Tobias66662/SPRO3---PCB-Design-/Main PCB/Step (Main PCB).step

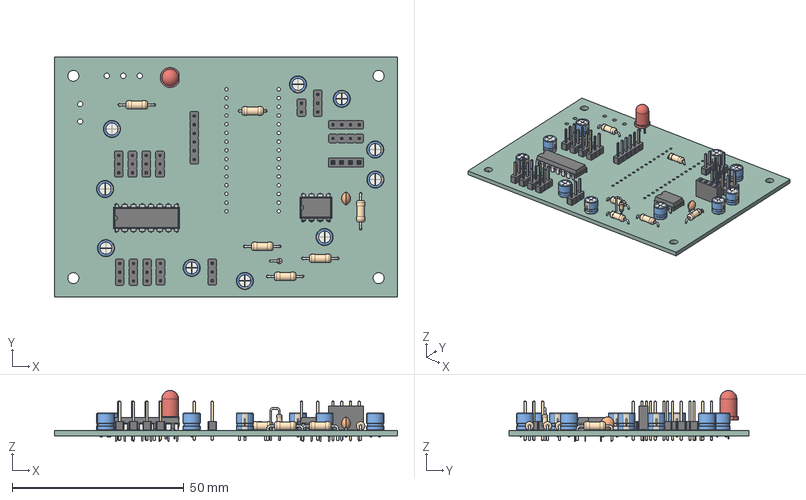
[picture p1: CAD file, 2024-12-10]
Main PCB/Step (Main PCB).step
100.0 x 70.0 x 14.9 mm
CP_Radial_D50mm_P250mm x 10
C_Disc_D38mm_W26mm_P250mm
R_Axial_DIN0207_L63mm_D25mm_P1016mm_Horizontal x 5
PinHeader_1x03_P254mm_Vertical x 10
DIP-8_W7.62mm
PinSocket_1x04_P254mm_Vertical
R_Axial_DIN0207_L63mm_D25mm_P762mm_Horizontal
PinHeader_1x06_P254mm_Vertical
PinHeader_1x04_P254mm_Vertical x 2
LED_D5.0mm
R_Axial_DIN0204_L36mm_D16mm_P254mm_Vertical
PinHeader_1x02_P254mm_Vertical
DIP-16_W7.62mm
Main PCB_PCB
