Tobias66662/SPRO3---PCB-Design-/2nd PCB/STEP (2nd PCB).step

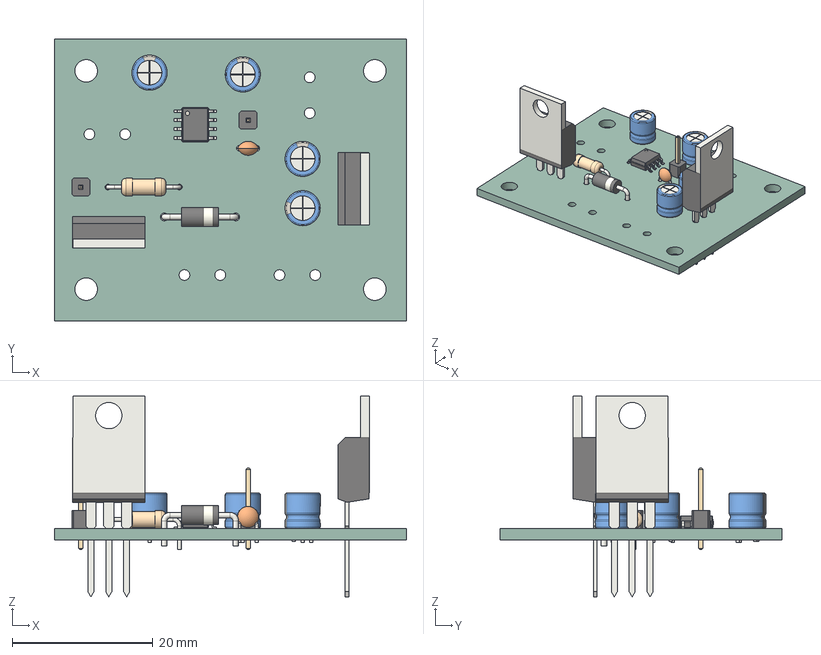
[picture p2: CAD file, 2024-12-10]
2nd PCB/STEP (2nd PCB).step
50.0 x 40.0 x 28.5 mm
CP_Radial_D50mm_P250mm x 4
D_DO-41_SOD81_P10.16mm_Horizontal
PinHeader_1x01_P254mm_Vertical x 2
C_Disc_D30mm_W20mm_P250mm
TO-220-3_Vertical x 2
R_Axial_DIN0207_L63mm_D25mm_P1016mm_Horizontal
SOIC_8_39x49mm_P127mm
2nd PCB_PCB
