Tobias66662/SPRO3---PCB-Design-/Main PCB/Main PCB.kicad_pcb

## KiCad design Main PCB/Main PCB.kicad_pcb (2024-12-17)

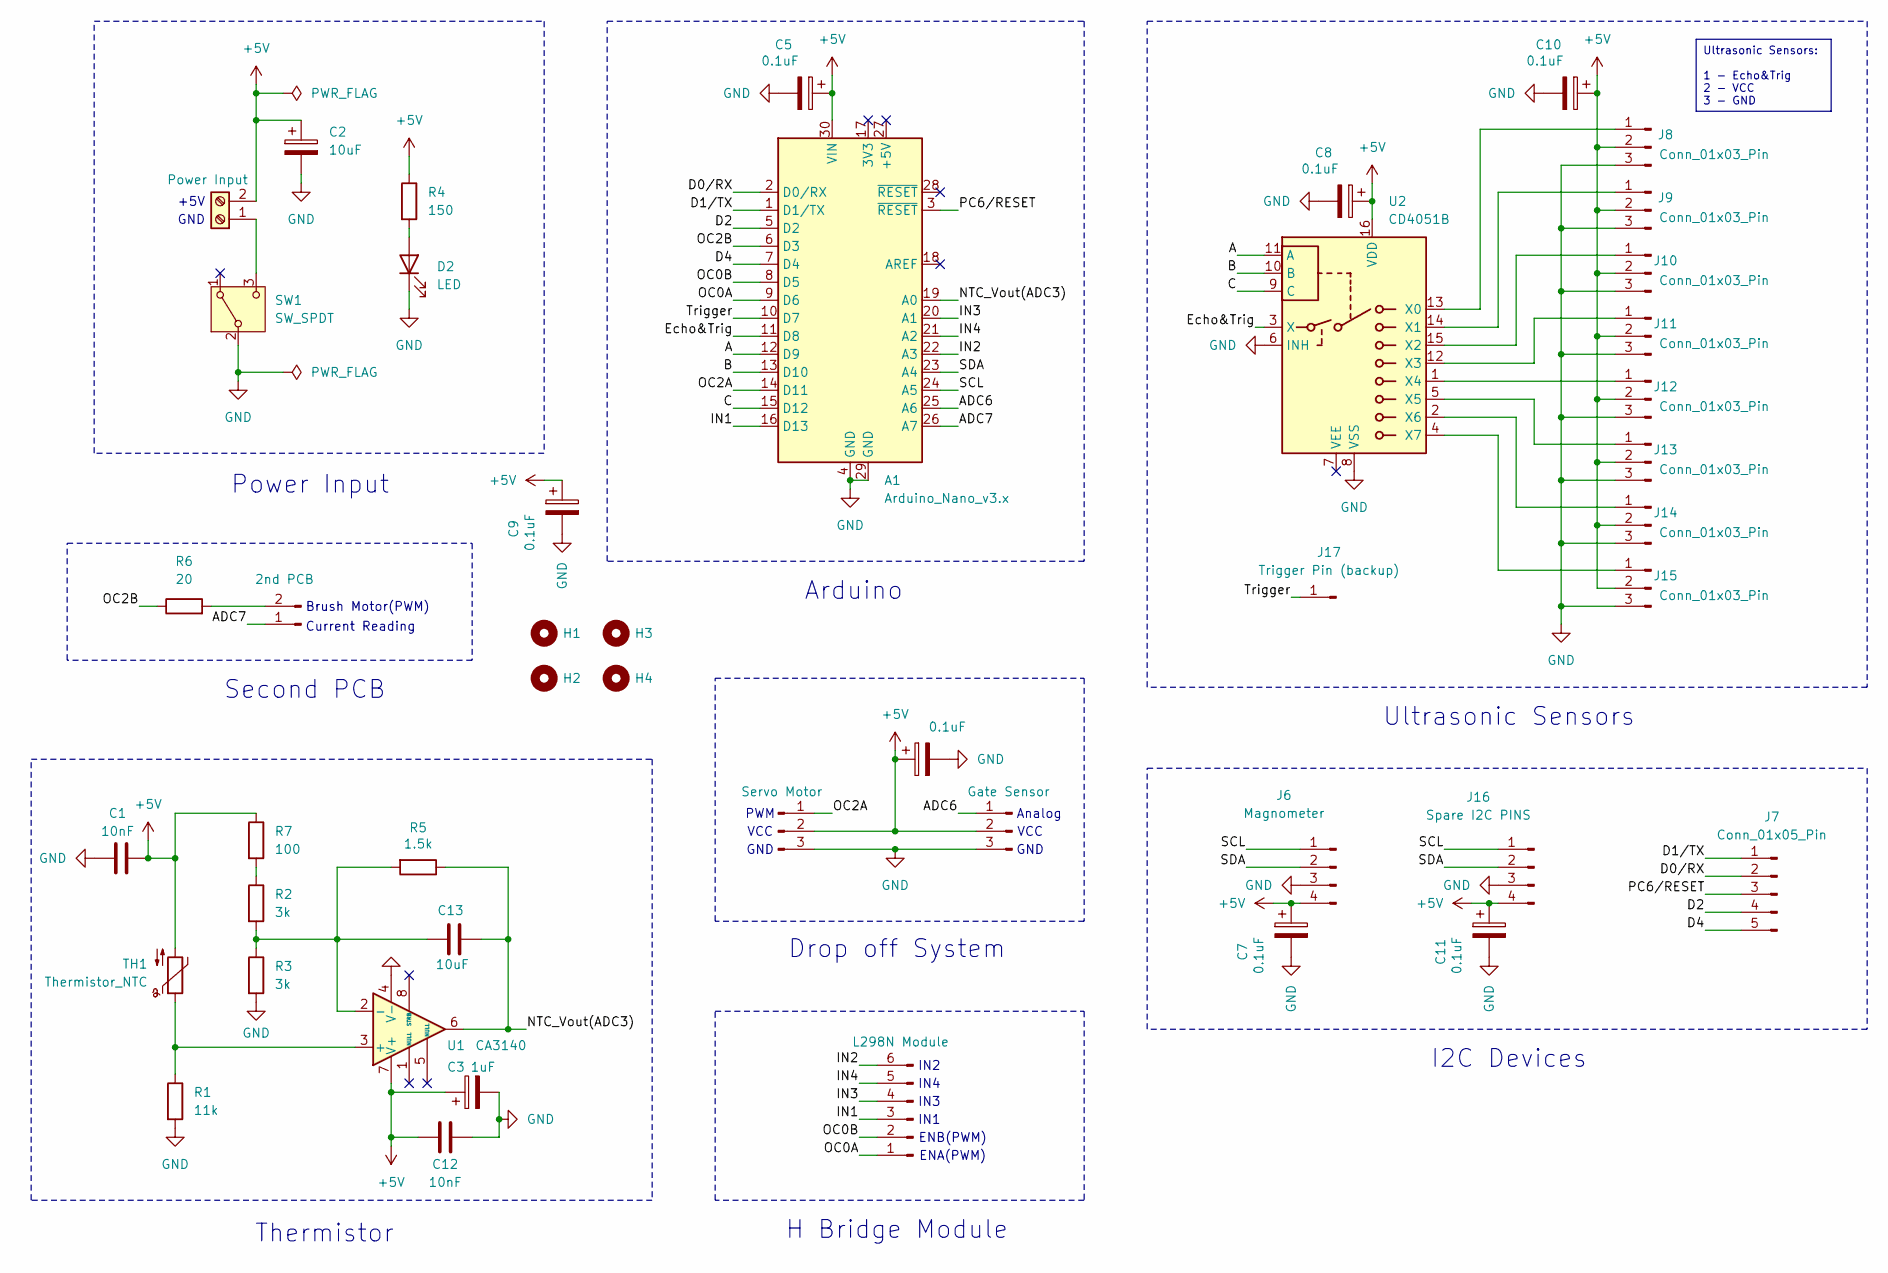
[picture p3: schematic Main PCB.kicad_sch]

Parts:
A1: Arduino_Nano_v3.x; Arduino_Nano
C1, C12: 10nF; C_Disc_D3.8mm_W2.6mm_P2.50mm
C2: 10uF; CP_Radial_D5.0mm_P2.50mm
C3: 1uF; CP_Radial_D5.0mm_P2.50mm
C5, C6, C7, C8, C9, C10, C11: 0.1uF; CP_Radial_D5.0mm_P2.50mm
C13: 10uF; C_Disc_D5.0mm_W2.5mm_P5.00mm
D2: LED; LED_D5.0mm
H1, H2, H3, H4: MountingHole; MountingHole_3.2mm_M3
J1: Power Input; TerminalBlock_bornier-2_P5.08mm
J2: 2nd PCB; PinHeader_1x02_P2.54mm_Vertical
J3: Servo Motor; PinHeader_1x03_P2.54mm_Vertical
J4: L298N Module; PinHeader_1x06_P2.54mm_Vertical
J5: Gate Sensor; PinHeader_1x03_P2.54mm_Vertical
J6: Magnometer; PinHeader_1x04_P2.54mm_Vertical
J7: Conn_01x05_Pin; PinHeader_1x05_P2.54mm_Vertical
J8, J9, J10, J11, J12, J13, J14, J15: Conn_01x03_Pin; PinHeader_1x03_P2.54mm_Vertical
J16: Spare I2C PINS; PinHeader_1x04_P2.54mm_Vertical
J17: Trigger Pin (backup); PinHeader_1x01_P2.54mm_Vertical
R1: 11k; R_Axial_DIN0207_L6.3mm_D2.5mm_P10.16mm_Horizontal
R2, R3: 3k; R_Axial_DIN0207_L6.3mm_D2.5mm_P10.16mm_Horizontal
R4: 150; R_Axial_DIN0207_L6.3mm_D2.5mm_P10.16mm_Horizontal
R5: 1.5k; R_Axial_DIN0207_L6.3mm_D2.5mm_P10.16mm_Horizontal
R6: 20; R_Axial_DIN0207_L6.3mm_D2.5mm_P7.62mm_Horizontal
R7: 100; R_Axial_DIN0207_L6.3mm_D2.5mm_P10.16mm_Horizontal
SW1: SW_SPDT; SolderWire-0.75sqmm_1x03_P4.8mm_D1.25mm_OD2.3mm
TH1: Thermistor_NTC; R_Axial_DIN0204_L3.6mm_D1.6mm_P2.54mm_Vertical
U1: CA3140; DIP-8_W7.62mm
U2: CD4051B; DIP-16_W7.62mm

Connections:
+5V: A1.30 (VIN), C1.2, C2.1, C3.1, C5.1, C6.1, C7.1, C8.1, C9.1, C10.1, C11.1, C12.1, J1.2, J3.2, J5.2, J6.4, J8.2, J9.2, J10.2, J11.2, J12.2, J13.2, J14.2, J15.2, J16.4, R4.1, R7.1, TH1.2, U1.7 (V+), U2.16 (VDD)
/A: A1.12 (D9), U2.11 (A)
/ADC6: A1.25 (A6), J5.1
/ADC7: A1.26 (A7), J2.1
/B: A1.13 (D10), U2.10 (B)
/C: A1.15 (D12), U2.9 (C)
/D0/RX: A1.2 (D0/RX), J7.2
/D1/TX: A1.1 (D1/TX), J7.1
/D2: A1.5 (D2), J7.4
/D4: A1.7 (D4), J7.5
/Echo&Trig: A1.11 (D8), U2.3 (X)
/IN1: A1.16 (D13), J4.3
/IN2: A1.22 (A3), J4.6
/IN3: A1.20 (A1), J4.4
/IN4: A1.21 (A2), J4.5
/NTC_Vout(ADC3): A1.19 (A0), C13.1, R5.1, U1.6
/OC0A: A1.9 (D6), J4.1
/OC0B: A1.8 (D5), J4.2
/OC2A: A1.14 (D11), J3.1
/OC2B: A1.6 (D3), R6.1
/PC6/RESET: A1.3 (~RESET), J7.3
/SCL: A1.24 (A5), J6.1, J16.1
/SDA: A1.23 (A4), J6.2, J16.2
/Trigger: A1.10 (D7), J17.1
GND: A1.4 (GND), A1.29 (GND), C1.1, C2.2, C3.2, C5.2, C6.2, C7.2, C8.2, C9.2, C10.2, C11.2, C12.2, D2.1 (K), J3.3, J5.3, J6.3, J8.3, J9.3, J10.3, J11.3, J12.3, J13.3, J14.3, J15.3, J16.3, R1.2, R3.2, SW1.2 (B), U1.4 (V-), U2.6 (INH), U2.8 (VSS)
unnamed: D2.2 (A), R4.2
unnamed: J1.1, SW1.3 (C)
unnamed: J2.2, R6.2
unnamed: J8.1, U2.13 (X0)
unnamed: J9.1, U2.14 (X1)
unnamed: J10.1, U2.15 (X2)
unnamed: J11.1, U2.12 (X3)
unnamed: J12.1, U2.1 (X4)
unnamed: J13.1, U2.5 (X5)
unnamed: J14.1, U2.2 (X6)
unnamed: J15.1, U2.4 (X7)
unnamed: R2.1, R7.2
unnamed: R1.1, TH1.1, U1.3 (+)
unnamed: C13.2, R2.2, R3.1, R5.2, U1.2 (-)

Notes on the sheet:
Ultrasonic Sensors: 1 - Echo&Trig 2 - VCC 3 - GND
GND
VCC
Arduino
Brush Motor(PWM)
IN1
Current Reading
I2C Devices
PWM
Analog
Drop off System
Second PCB
ENA(PWM)
ENB(PWM)
IN3
Thermistor
Power Input
Ultrasonic Sensors
+5V
IN2
H Bridge Module
IN4

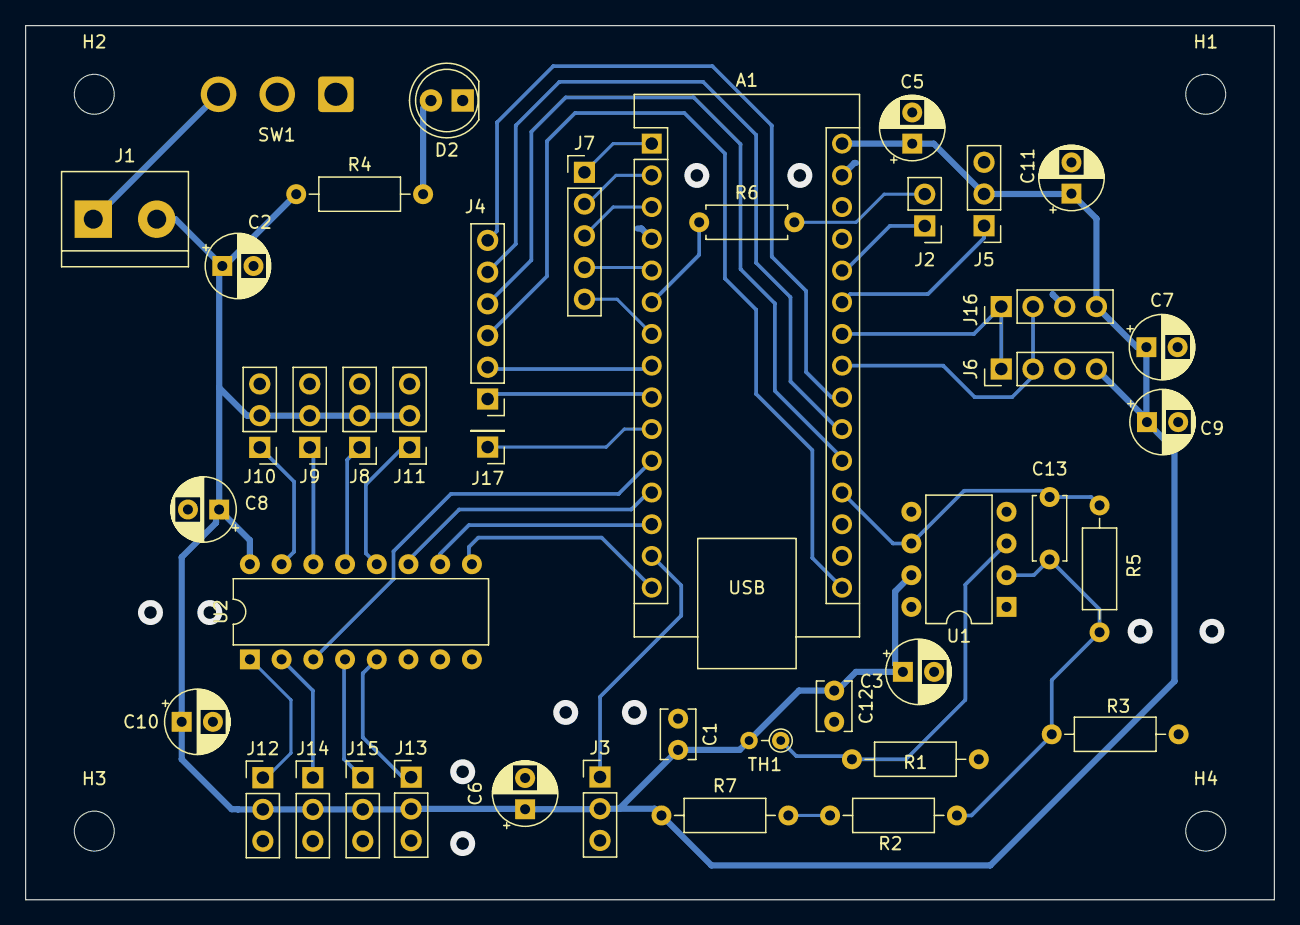
[picture p4: board Main PCB.kicad_pcb from above]

Board: 2 copper layers, 100.0 x 70.0 mm, 46 parts (0 on the bottom side), 39 nets.
