Tobias66662/SPRO3---PCB-Design-/2nd PCB/2nd PCB.kicad_pcb

## KiCad design 2nd PCB/2nd PCB.kicad_pcb (2024-11-27)

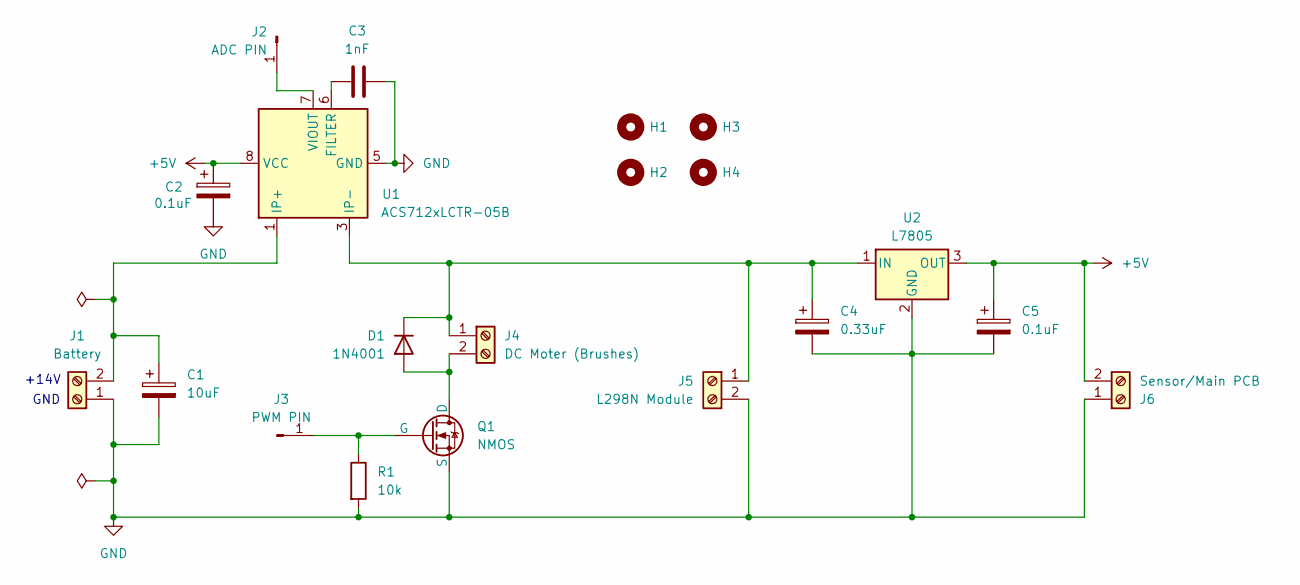
[picture p5: schematic 2nd PCB.kicad_sch]

Parts:
C1: 10uF; CP_Radial_D5.0mm_P2.50mm
C2, C5: 0.1uF; CP_Radial_D5.0mm_P2.50mm
C3: 1nF; C_Disc_D3.0mm_W2.0mm_P2.50mm
C4: 0.33uF; CP_Radial_D5.0mm_P2.50mm
D1: 1N4001; D_DO-41_SOD81_P10.16mm_Horizontal
H1, H2, H3, H4: MountingHole; MountingHole_3.2mm_M3
J1: Battery; TerminalBlock_bornier-2_P5.08mm
J2: ADC PIN; PinHeader_1x01_P2.54mm_Vertical
J3: PWM PIN; PinHeader_1x01_P2.54mm_Vertical
J4: DC Moter (Brushes); TerminalBlock_bornier-2_P5.08mm
J5: L298N Module; TerminalBlock_bornier-2_P5.08mm
J6: Sensor/Main PCB; TerminalBlock_bornier-2_P5.08mm
Q1: NMOS; TO-220-3_Vertical
R1: 10k; R_Axial_DIN0207_L6.3mm_D2.5mm_P10.16mm_Horizontal
U1: ACS712xLCTR-05B; SOIC-8_3.9x4.9mm_P1.27mm
U2: L7805; TO-220-3_Vertical

Connections:
+5V: C2.1, C5.1, J6.2, U1.8 (VCC), U2.3 (OUT)
GND: C1.2, C2.2, C3.1, C4.2, C5.2, J1.1, J5.2, J6.1, Q1.3 (S), R1.2, U1.5 (GND), U2.2 (GND)
unnamed: D1.2 (A), J4.2, Q1.1 (D)
unnamed: C4.1, D1.1 (K), J4.1, J5.1, U1.3 (IP-), U1.4 (IP-), U2.1 (IN)
unnamed: C1.1, J1.2, U1.1 (IP+), U1.2 (IP+)
unnamed: J2.1, U1.7 (VIOUT)
unnamed: J3.1, Q1.2 (G), R1.1
unnamed: C3.2, U1.6 (FILTER)

Notes on the sheet:
GND
+14V

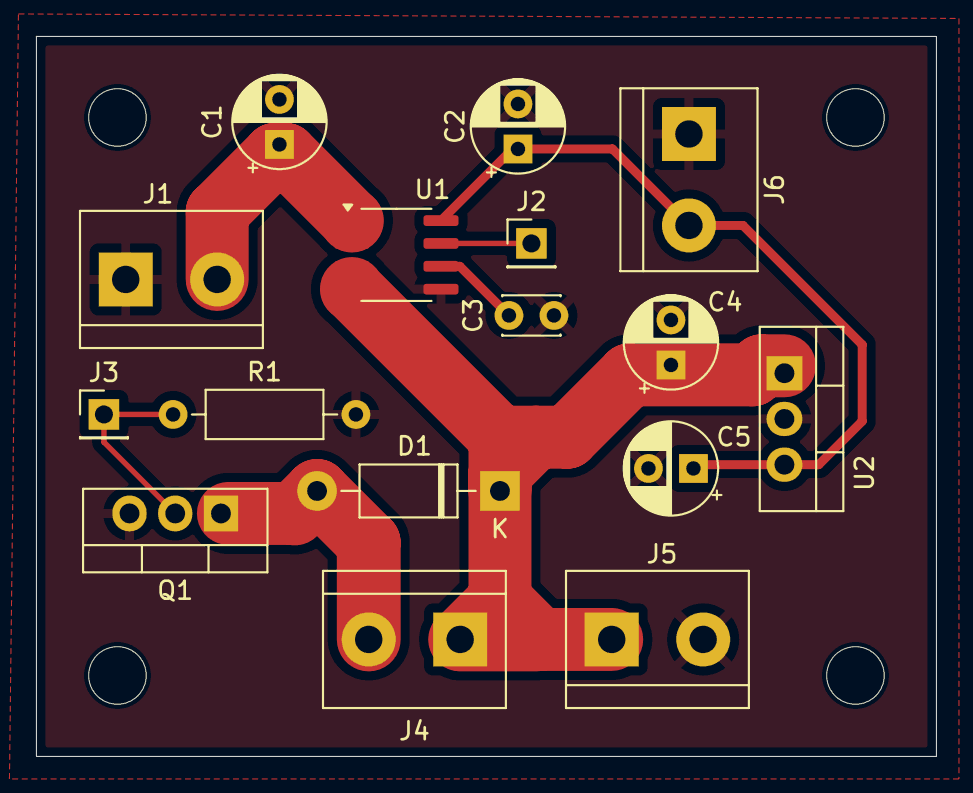
[picture p6: board 2nd PCB.kicad_pcb from above]

Board: 2 copper layers, 50.0 x 40.0 mm, 20 parts (0 on the bottom side), 8 nets.
