Tobias66662/SPRO3---PCB-Design-/(commit log)

2024-11-02 Initaial commit
    [SPRO3 - PCB.kicad_pcb, SPRO3 - PCB.kicad_sch]
2024-11-03 added components to the schematic
    [SPRO3 - PCB.kicad_pcb, SPRO3 - PCB.kicad_sch]
2024-11-03 Added bypass capacitor to MUX
    [SPRO3 - PCB.kicad_sch]
2024-11-13 udated MUX schematic
    [SPRO3 - PCB.kicad_sch]
2024-11-18 Added Kicad files for the second PCB that we are making
    [2nd PCB.kicad_pcb, 2nd PCB.kicad_sch, SPRO3 - PCB.kicad_sch]
2024-11-18 Added linear voltage regulator to 2nd PCB
    [2nd PCB.kicad_sch]
2024-11-19 Added labels and pin connections to the main PCB
    [SPRO3 - PCB.kicad_sch]
2024-11-22 Added footnotes to the main PCB and tested and tested stuff in the board editor
    [SPRO3 - PCB.kicad_pcb, SPRO3 - PCB.kicad_sch]
2024-11-23 First attempt at designing the board for the second PCB
    [2nd PCB.kicad_pcb, 2nd PCB.kicad_sch, SPRO3 - PCB.kicad_pcb]
2024-11-23 First attempt at designing the main PCB board
    [SPRO3 - PCB.kicad_pcb, SPRO3 - PCB.kicad_sch]
2024-11-24 Made some edits to the main PCB board
    [SPRO3 - PCB.kicad_pcb, SPRO3 - PCB.kicad_sch]
2024-11-25 Added to main PCB board
    [2nd PCB.kicad_sch, SPRO3 - PCB.kicad_pcb]
2024-11-25 finished the PCB board designs
    [2nd PCB.kicad_pcb, 2nd PCB.kicad_sch, SPRO3 - PCB.kicad_pcb, SPRO3 - PCB.kicad_sch]
2024-11-27 First iteration of both PCB's send for review
    [2nd PCB.kicad_pcb, 2nd PCB.kicad_sch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]
2024-11-27 Removed Main PCB from 2nd PCB folder
    [Bill-of-Material (Main PCB).csv, Main PCB.kicad_pcb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]
2024-12-10 Second revision
    [2nd PCB.kicad_sch, Bill-of-Material (Main PCB).csv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]
2024-12-17 Added manual vias
    [Main PCB.kicad_pcb, Main PCB.kicad_sch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]
